nikolaus018/dji-fcc-esp32/hardware/fab/bom_full.csv

Qty | Value | Designators | Footprint | MPN | LCSC | Missing LCSC?
1 | 1uF | C1 | C_0603_1608Metric |  | C15849
6 | 10uF | C2 C4 C5 C6 C7 C13 | C_0805_2012Metric |  | C15850
5 | 100nF | C3 C8 C12 C14 C15 | C_0603_1608Metric |  | C14663
3 | 22uF | C9 C10 C11 | C_0805_2012Metric |  | C45783
2 | SMF5.0A | D1 D5 | D_SOD-123F | SMF5.0A | C707993
1 | SS34 | D4 | D_SMA | SS34 | C8678
1 | RED | D6 | LED_0603_1608Metric |  | C2286
1 | GREEN | D7 | LED_0603_1608Metric |  | C2986059
1 | BLUE | D8 | LED_0603_1608Metric |  | C2986058
2 | USB-C | J1 J2 | USB_C_Receptacle_HRO_TYPE-C-31-M-12 | TYPE-C-31-M-12 | C165948
1 | BATTERY 1S LiPo (+ on pin 1) | J3 | JST_PH_S2B-PH-SM4-TB_1x02-1MP_P2.00mm_Horizontal | S2B-PH-SM4-TB | C295747
1 | 4.7uH | L1 | L_Sunlord_SWPA4020S | SWPA4020S4R7MT | C48427
1 | FS8205A | Q1 | TSSOP-8_4.4x3mm_P0.65mm | FS8205A | C5148694
1 | 10k | R1 | R_0603_1608Metric |  | C25804
2 | 5.1k | R2 R3 | R_0603_1608Metric |  | C23186
1 | 4.7k | R4 | R_0603_1608Metric |  | C23162
1 | 100 | R7 | R_0603_1608Metric |  | C22775
1 | 1k | R8 | R_0603_1608Metric |  | C21190
1 | 220k | R9 | R_0603_1608Metric |  | C22961
1 | 30k | R10 | R_0603_1608Metric |  | C22984
4 | 100k | R11 R13 R14 R22 | R_0603_1608Metric |  | C25803
1 | 47k | R12 | R_0603_1608Metric |  | C25819
2 | 33k | R15 R16 | R_0603_1608Metric |  | C4216
2 | 470 | R17 R18 | R_0603_1608Metric |  | C23179
1 | 220 | R19 | R_0603_1608Metric |  | C22962
2 | 1M | R20 R21 | R_0603_1608Metric |  | C22935
1 | 150k | R23 | R_0603_1608Metric |  | C22807
1 | ESP32-S3-MINI-1-N8 | U1 | ESP32-S2-MINI-1 | ESP32-S3-MINI-1-N8 | C2913206
1 | AP2112K-3.3 | U2 | SOT-23-5 | AP2112K-3.3TRG1 | C51118
1 | TP4056 | U3 | SOIC-8-1EP_3.9x4.9mm_P1.27mm_EP2.41x3.3mm | TP4056-42-ESOP8 | C16581
1 | DW01A | U4 | SOT-23-6 | DW01A | C2927799
1 | MT3608 | U5 | SOT-23-6 | MT3608 | C84817
1 | TPS2553DBVR | U6 | SOT-23-6 | TPS2553DBVR | C55266
2 | USBLC6-2SC6 | U7 U9 | SOT-23-6 | USBLC6-2SC6 | C7519
1 | FSUSB42MUX | U8 | MSOP-10_3x3mm_P0.5mm | FSUSB42MUX | C11355
