nikolaus018/dji-fcc-esp32/hardware/fab/dji-fcc.step

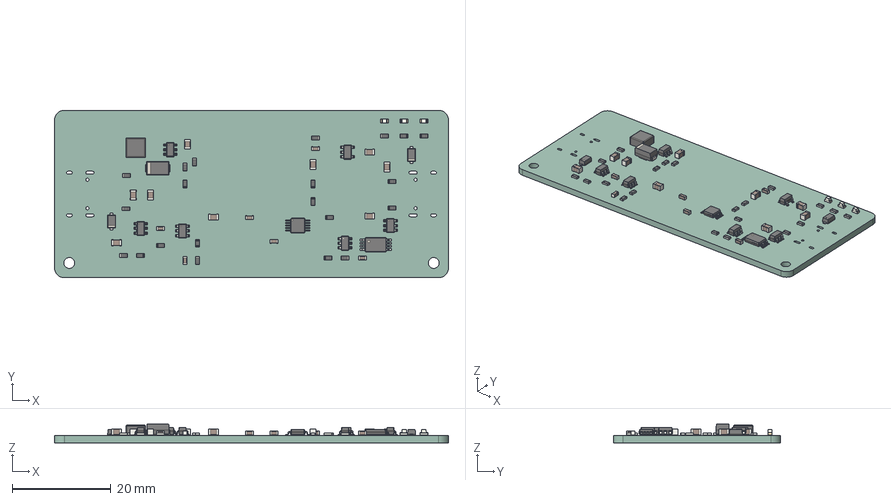
[picture p3: CAD file, 2026-10-11]
hardware/fab/dji-fcc.step
80.0 x 34.0 x 3.82 mm
C_0603_1608Metric x 6
R_0603_1608Metric x 21
SOT-23-6 x 5
LED_0603_1608Metric x 3
SOT-23-5
C_0805_2012Metric x 9
a671c444-8551-11ed-a139-00155d22e2d7_part
a671c57a-8551-11ed-a139-00155d22e2d7_part
a671c5fc-8551-11ed-a139-00155d22e2d7_part
TSSOP-8_4.4x3mm_P0.65mm
D_SMA
D_SOD_123F x 2
MSOP-10_3x3mm_P0.5mm
dji-fcc_PCB
