nikolaus018/dji-fcc-esp32/hardware/docs/schematic.pdf

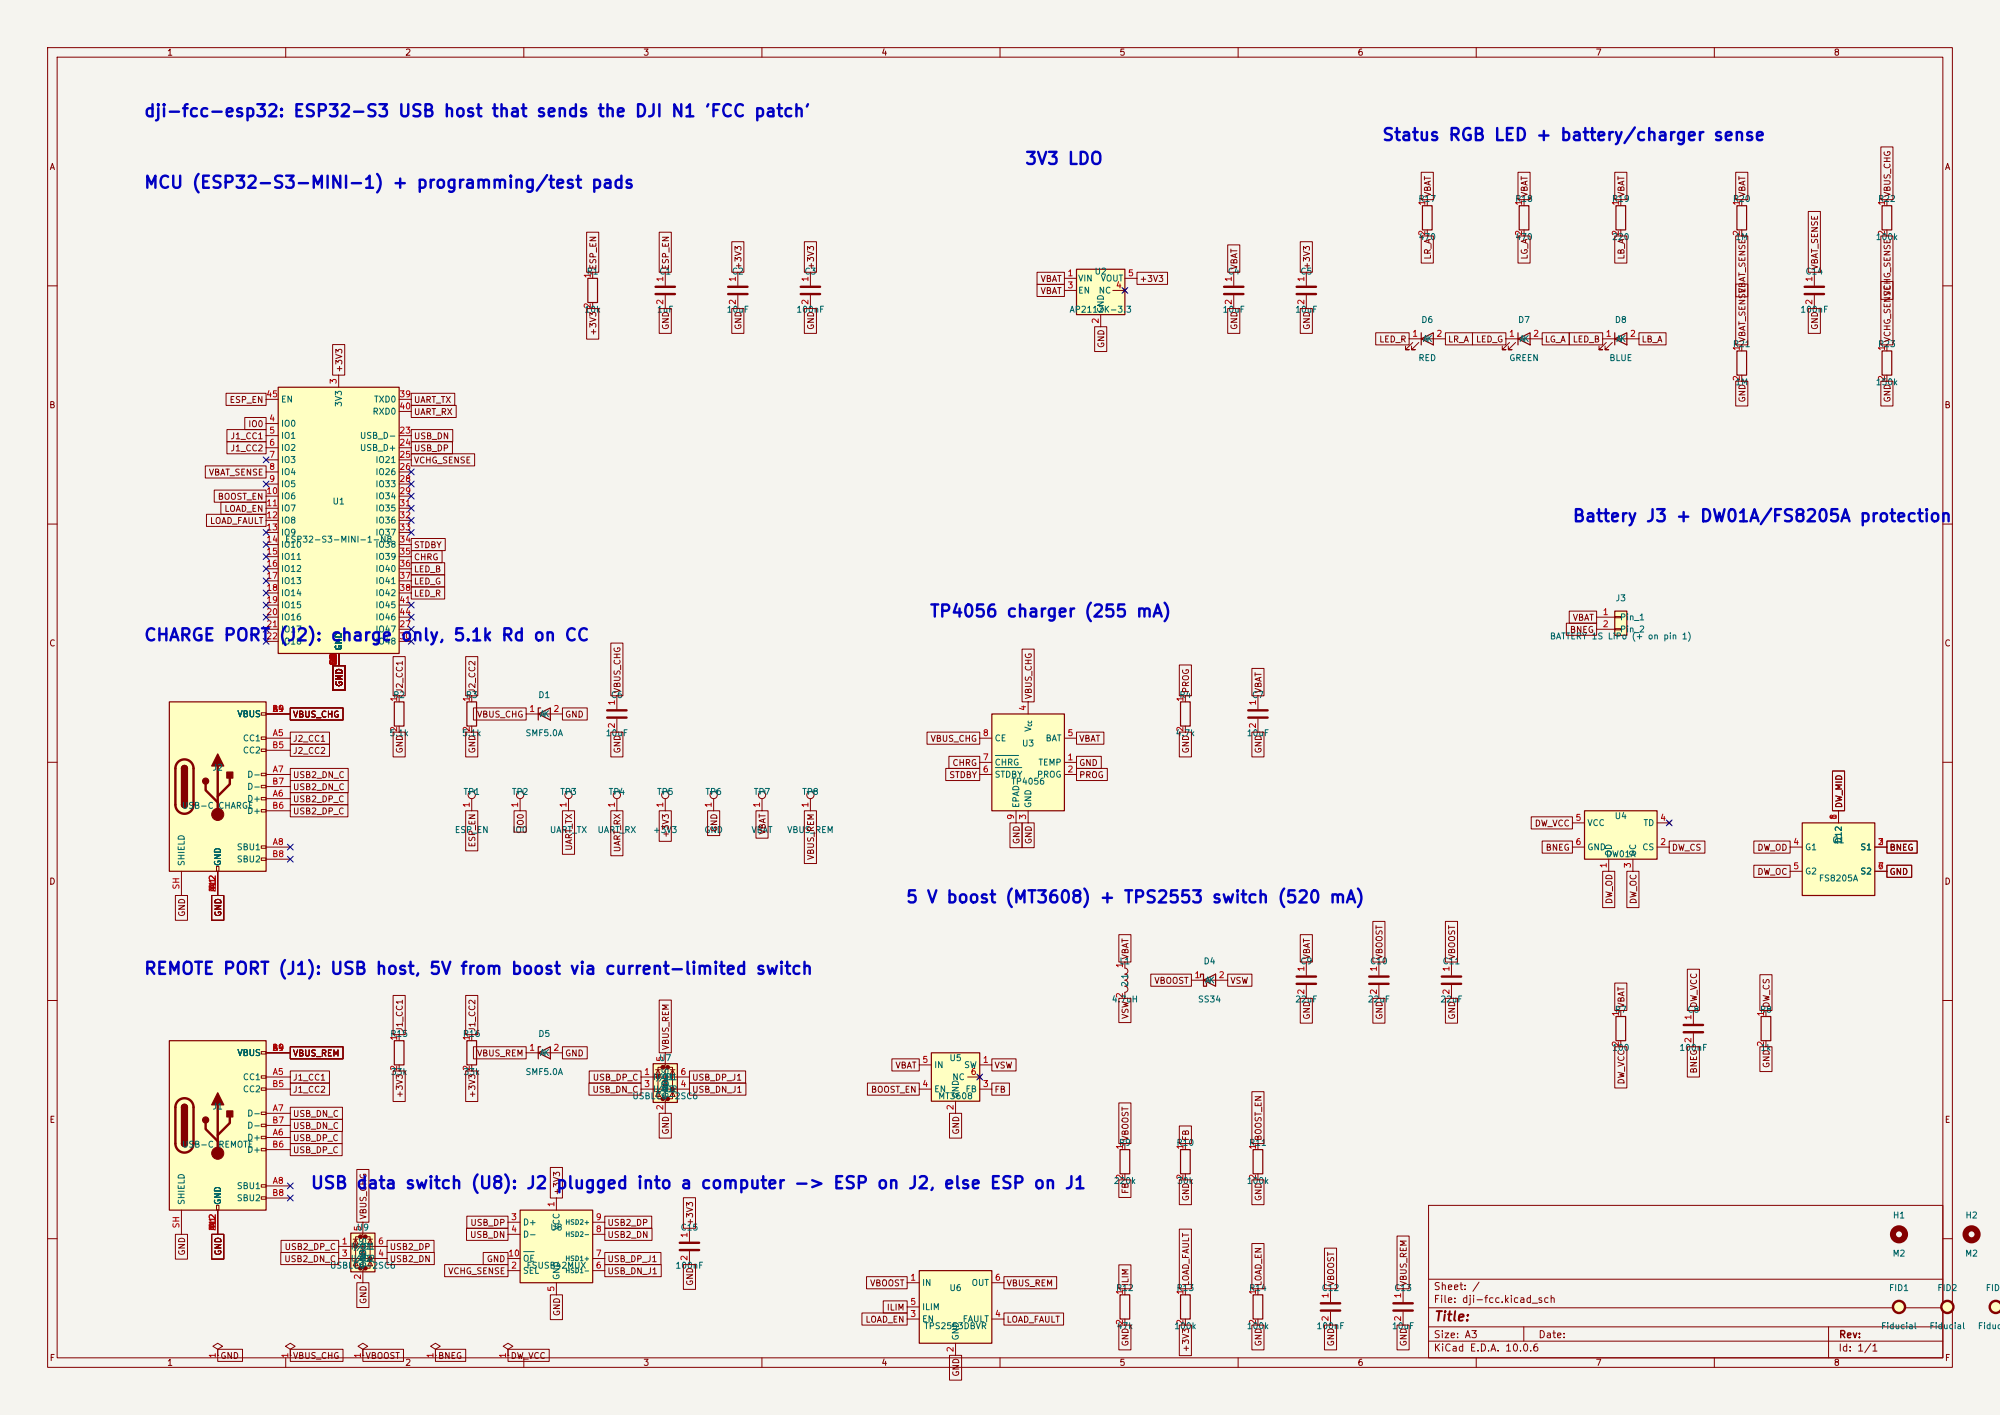
[picture p4: page 1]

dji-fcc-esp32: ESP32-S3 USB host that sends the DJI N1 'FCC patch'

Status RGB LED + battery/charger sense

MCU (ESP32-S3-MINI-1) + programming/test pads

J3 BATTERY 1S LiPo (+ on pin 1) OD

REMOTE PORT (J1): USB host, 5V from boost via current-limited switch

Size: A3 | Rev: | F Date:
KiCad E.D.A. 10.0.6 | Id: 1/1
