nikolaus018/dji-fcc-esp32/hardware/docs/pcb_bottom.pdf

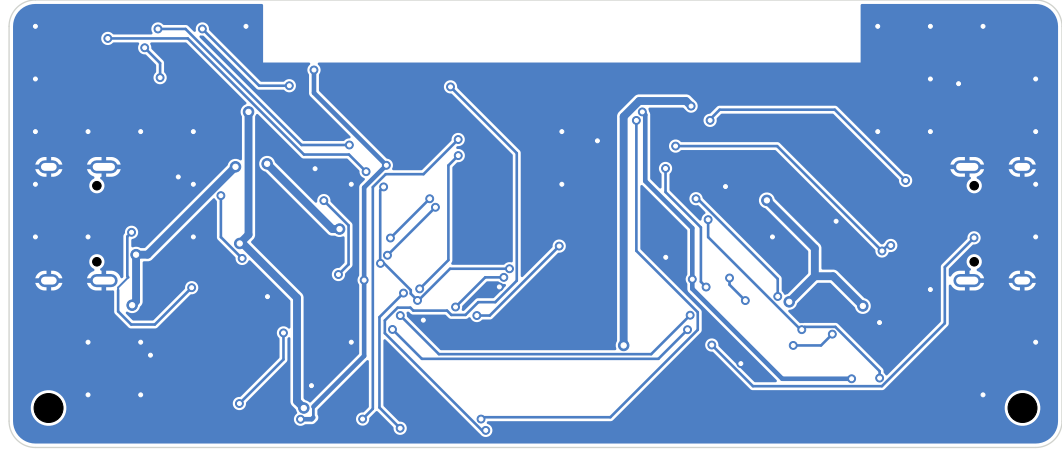
[picture p5: page 1]
