nikolaus018/dji-fcc-esp32/hardware/docs/pcb_top.pdf

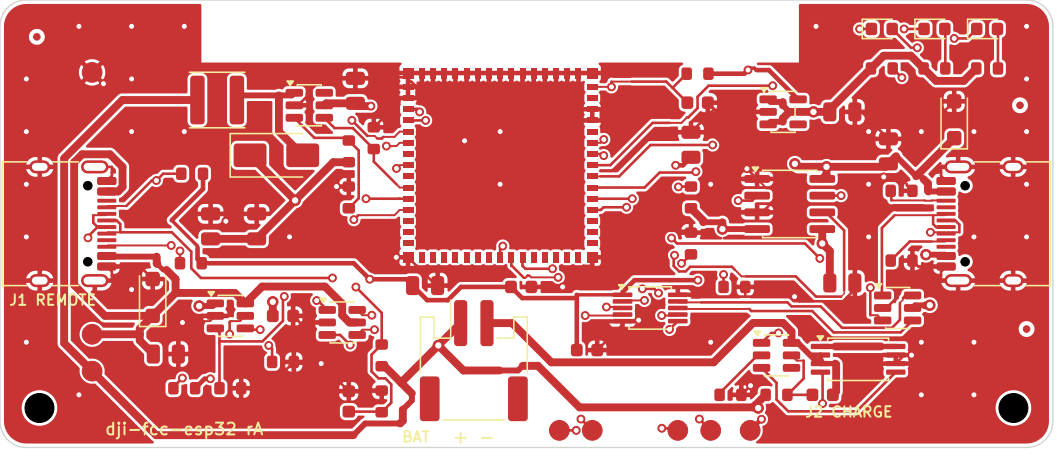
[picture p6: page 1]
