nikolaus018/dji-fcc-esp32/hardware/dji-fcc.kicad_pcb

## KiCad design hardware/dji-fcc.kicad_pcb (2026-10-11)

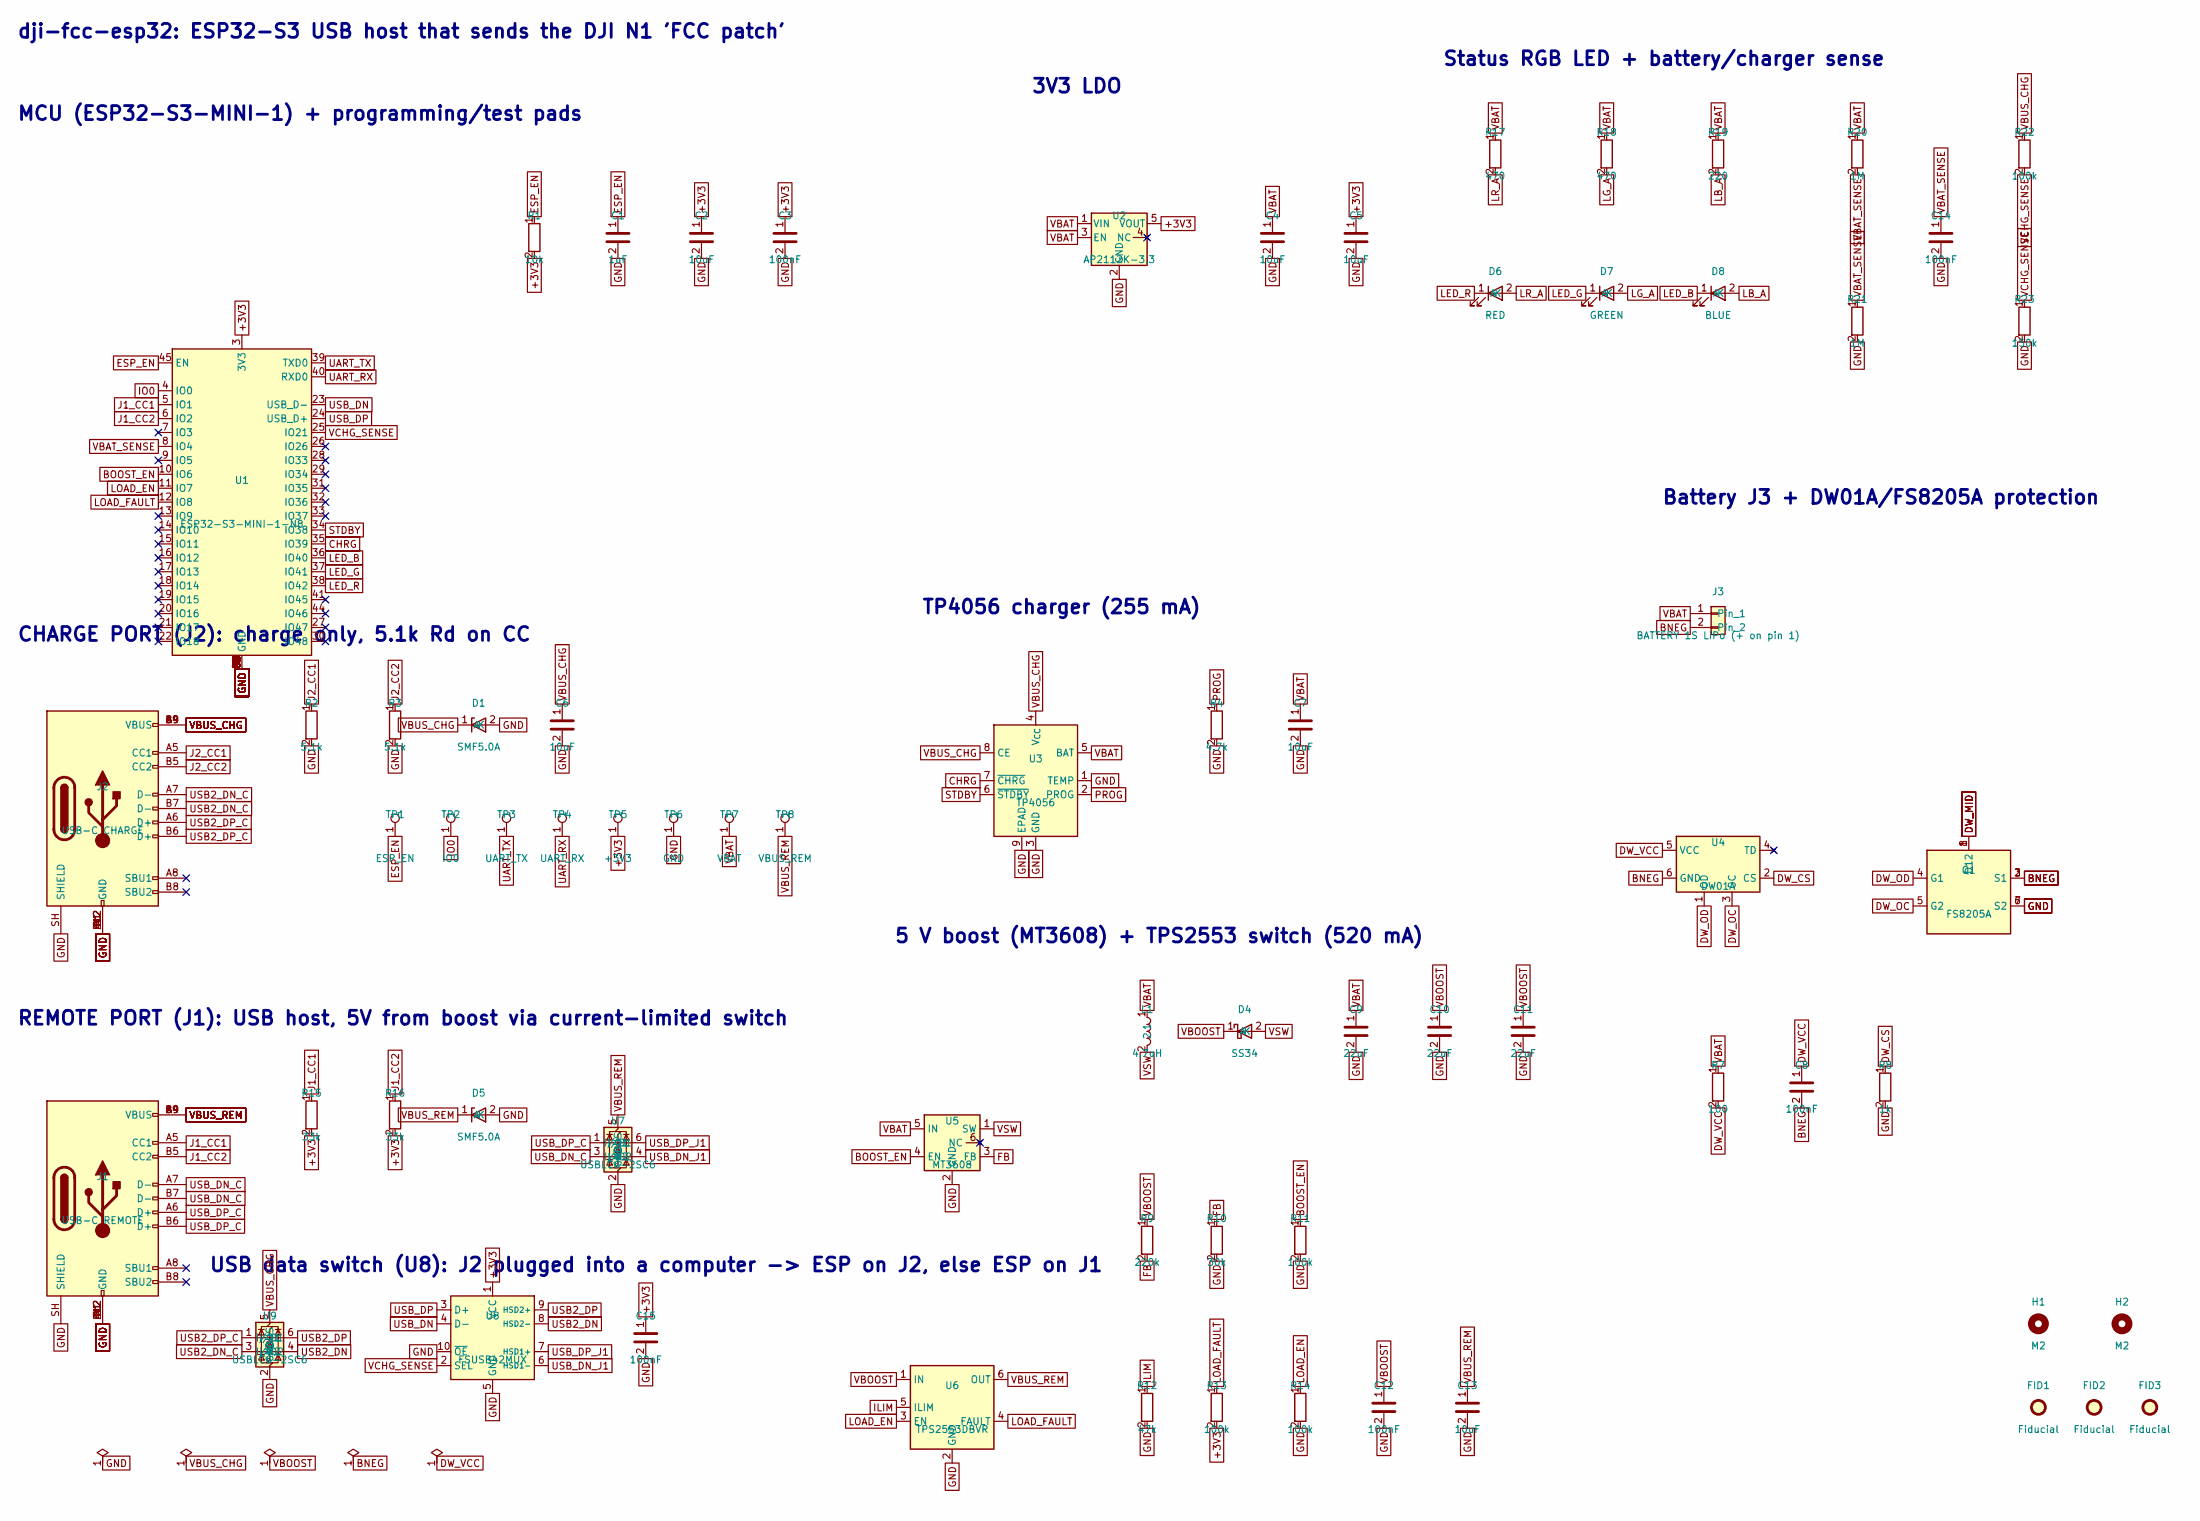
[picture p7: schematic dji-fcc.kicad_sch]

Parts:
C1: 1uF; C_0603_1608Metric
C2, C4, C5, C6, C7, C13: 10uF; C_0805_2012Metric
C3, C8, C12, C14, C15: 100nF; C_0603_1608Metric
C9, C10, C11: 22uF; C_0805_2012Metric
D1, D5: SMF5.0A; D_SOD-123F; MPN SMF5.0A
D4: SS34; D_SMA; MPN SS34
D6: RED; LED_0603_1608Metric
D7: GREEN; LED_0603_1608Metric
D8: BLUE; LED_0603_1608Metric
FID1, FID2, FID3: Fiducial; Fiducial_0.5mm_Mask1mm
H1, H2: M2; MountingHole_2.2mm_M2
J1: USB-C REMOTE; USB_C_Receptacle_HRO_TYPE-C-31-M-12; MPN TYPE-C-31-M-12
J2: USB-C CHARGE; USB_C_Receptacle_HRO_TYPE-C-31-M-12; MPN TYPE-C-31-M-12
J3: BATTERY 1S LiPo (+ on pin 1); JST_PH_S2B-PH-SM4-TB_1x02-1MP_P2.00mm_Horizontal; MPN S2B-PH-SM4-TB
L1: 4.7uH; L_Sunlord_SWPA4020S; MPN SWPA4020S4R7MT
Q1: FS8205A; TSSOP-8_4.4x3mm_P0.65mm; MPN FS8205A
R1: 10k; R_0603_1608Metric
R2, R3: 5.1k; R_0603_1608Metric
R4: 4.7k; R_0603_1608Metric
R7: 100; R_0603_1608Metric
R8: 1k; R_0603_1608Metric
R9: 220k; R_0603_1608Metric
R10: 30k; R_0603_1608Metric
R11, R13, R14, R22: 100k; R_0603_1608Metric
R12: 47k; R_0603_1608Metric
R15, R16: 33k; R_0603_1608Metric
R17, R18: 470; R_0603_1608Metric
R19: 220; R_0603_1608Metric
R20, R21: 1M; R_0603_1608Metric
R23: 150k; R_0603_1608Metric
TP1: ESP_EN; TestPoint_Pad_D1.5mm
TP2: IO0; TestPoint_Pad_D1.5mm
TP3: UART_TX; TestPoint_Pad_D1.5mm
TP4: UART_RX; TestPoint_Pad_D1.5mm
TP5: +3V3; TestPoint_Pad_D1.5mm
TP6: GND; TestPoint_Pad_D1.5mm
TP7: VBAT; TestPoint_Pad_D1.5mm
TP8: VBUS_REM; TestPoint_Pad_D1.5mm
U1: ESP32-S3-MINI-1-N8; ESP32-S2-MINI-1; MPN ESP32-S3-MINI-1-N8
U2: AP2112K-3.3; SOT-23-5; MPN AP2112K-3.3TRG1
U3: TP4056; SOIC-8-1EP_3.9x4.9mm_P1.27mm_EP2.41x3.3mm; MPN TP4056-42-ESOP8
U4: DW01A; SOT-23-6; MPN DW01A
U5: MT3608; SOT-23-6; MPN MT3608
U6: TPS2553DBVR; SOT-23-6; MPN TPS2553DBVR
U7, U9: USBLC6-2SC6; SOT-23-6; MPN USBLC6-2SC6
U8: FSUSB42MUX; MSOP-10_3x3mm_P0.5mm; MPN FSUSB42MUX

Connections:
+3V3: C2.1, C3.1, C5.1, C15.1, R1.2, R13.2, R15.2, R16.2, TP5.1, U1.3 (3V3), U2.5 (VOUT), U8.1 (VCC)
BNEG: C8.2, J3.2, Q1.2 (S1), Q1.3 (S1), U4.6 (GND)
BOOST_EN: R11.1, U1.10 (IO6), U5.4 (EN)
CHRG: U1.35 (IO39), U3.7 (~CHRG)
DW_CS: R8.1, U4.2 (CS)
DW_MID: Q1.1 (D12), Q1.8 (D12)
DW_OC: Q1.5 (G2), U4.3 (OC)
DW_OD: Q1.4 (G1), U4.1 (OD)
DW_VCC: C8.1, R7.2, U4.5 (VCC)
ESP_EN: C1.1, R1.1, TP1.1, U1.45 (EN)
FB: R9.2, R10.1, U5.3 (FB)
GND: C1.2, C2.2, C3.2, C4.2, C5.2, C6.2, C7.2, C9.2, C10.2, C11.2, C12.2, C13.2, C14.2, C15.2, D1.2 (A), D5.2 (A), J1.A1 (GND), J1.A12 (GND), J1.B1 (GND), J1.B12 (GND), J1.SH (SHIELD), J2.A1 (GND), J2.A12 (GND), J2.B1 (GND), J2.B12 (GND), J2.SH (SHIELD), Q1.6 (S2), Q1.7 (S2), R2.2, R3.2, R4.2, R8.2, R10.2, R11.2, R12.2, R14.2, R21.2, R23.2, TP6.1, U1.1 (GND), U1.2 (GND), U1.42 (GND), U1.43 (GND), U1.46 (GND), U1.47 (GND), U1.48 (GND), U1.49 (GND), U1.50 (GND), U1.51 (GND), U1.52 (GND), U1.53 (GND), U1.54 (GND), U1.55 (GND), U1.56 (GND), U1.57 (GND), U1.58 (GND), U1.59 (GND), U1.60 (GND), U1.61 (GND), U1.62 (GND), U1.63 (GND), U1.64 (GND), U1.65 (GND), U2.2 (GND), U3.1 (TEMP), U3.3 (GND), U3.9 (EPAD), U5.2 (GND), U6.2 (GND), U7.2 (GND), U8.5 (GND), U8.10 (~OE), U9.2 (GND)
ILIM: R12.1, U6.5 (ILIM)
IO0: TP2.1, U1.4 (IO0)
J1_CC1: J1.A5 (CC1), R15.1, U1.5 (IO1)
J1_CC2: J1.B5 (CC2), R16.1, U1.6 (IO2)
J2_CC1: J2.A5 (CC1), R2.1
J2_CC2: J2.B5 (CC2), R3.1
LB_A: D8.2 (A), R19.2
LED_B: D8.1 (K), U1.36 (IO40)
LED_G: D7.1 (K), U1.37 (IO41)
LED_R: D6.1 (K), U1.38 (IO42)
LG_A: D7.2 (A), R18.2
LOAD_EN: R14.1, U1.11 (IO7), U6.3 (EN)
LOAD_FAULT: R13.1, U1.12 (IO8), U6.4 (FAULT)
LR_A: D6.2 (A), R17.2
PROG: R4.1, U3.2 (PROG)
STDBY: U1.34 (IO38), U3.6 (~STDBY)
UART_RX: TP4.1, U1.40 (RXD0)
UART_TX: TP3.1, U1.39 (TXD0)
USB2_DN: U8.8 (HSD2-), U9.4 (I/O2)
USB2_DN_C: J2.A7 (D-), J2.B7 (D-), U9.3 (I/O2)
USB2_DP: U8.9 (HSD2+), U9.6 (I/O1)
USB2_DP_C: J2.A6 (D+), J2.B6 (D+), U9.1 (I/O1)
USB_DN: U1.23 (USB_D-), U8.4 (D-)
USB_DN_C: J1.A7 (D-), J1.B7 (D-), U7.3 (I/O2)
USB_DN_J1: U7.4 (I/O2), U8.6 (HSD1-)
USB_DP: U1.24 (USB_D+), U8.3 (D+)
USB_DP_C: J1.A6 (D+), J1.B6 (D+), U7.1 (I/O1)
USB_DP_J1: U7.6 (I/O1), U8.7 (HSD1+)
VBAT: C4.1, C7.1, C9.1, J3.1, L1.1, R7.1, R17.1, R18.1, R19.1, R20.1, TP7.1, U2.1 (VIN), U2.3 (EN), U3.5 (BAT), U5.5 (IN)
VBAT_SENSE: C14.1, R20.2, R21.1, U1.8 (IO4)
VBOOST: C10.1, C11.1, C12.1, D4.1 (K), R9.1, U6.1 (IN)
VBUS_CHG: C6.1, D1.1 (K), J2.A4 (VBUS), J2.A9 (VBUS), J2.B4 (VBUS), J2.B9 (VBUS), R22.1, U3.4 (V_{CC}), U3.8 (CE), U9.5 (VBUS)
VBUS_REM: C13.1, D5.1 (K), J1.A4 (VBUS), J1.A9 (VBUS), J1.B4 (VBUS), J1.B9 (VBUS), TP8.1, U6.6 (OUT), U7.5 (VBUS)
VCHG_SENSE: R22.2, R23.1, U1.25 (IO21), U8.2 (SEL)
VSW: D4.2 (A), L1.2, U5.1 (SW)

Notes on the sheet:
dji-fcc-esp32: ESP32-S3 USB host that sends the DJI N1 'FCC patch'
MCU (ESP32-S3-MINI-1) + programming/test pads
3V3 LDO
Status RGB LED + battery/charger sense
REMOTE PORT (J1): USB host, 5V from boost via current-limited switch
5 V boost (MT3608) + TPS2553 switch (520 mA)
USB data switch (U8): J2 plugged into a computer -> ESP on J2, else ESP on J1
CHARGE PORT (J2): charge only, 5.1k Rd on CC
TP4056 charger (255 mA)
Battery J3 + DW01A/FS8205A protection

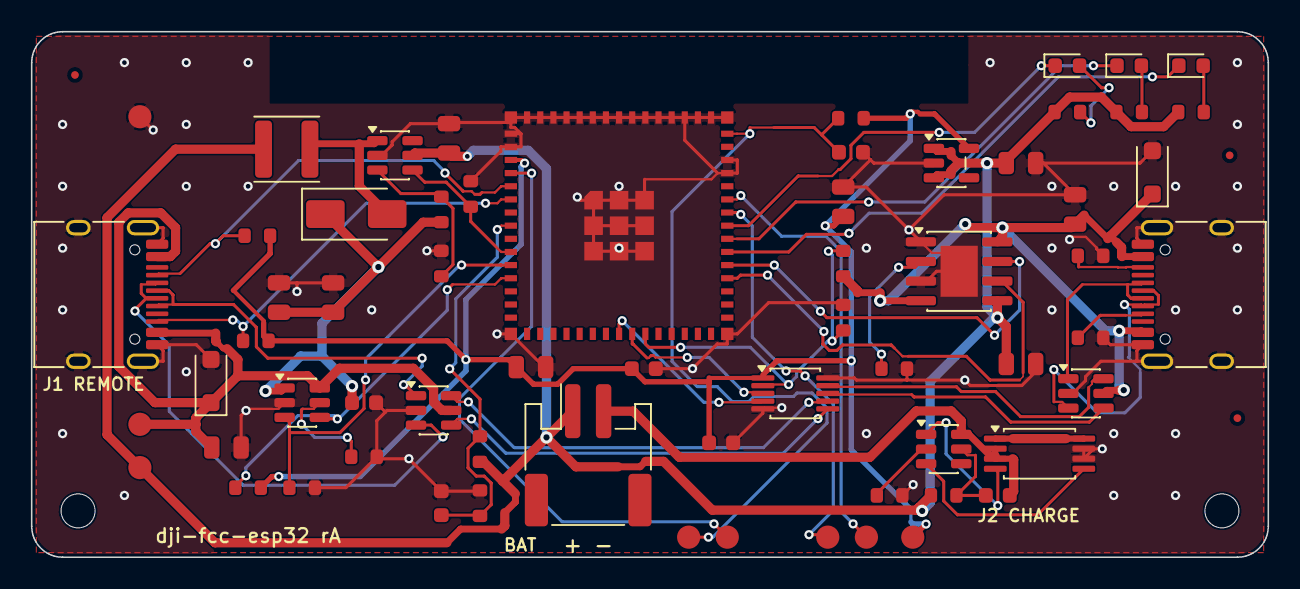
[picture p8: board dji-fcc.kicad_pcb from above]

Board: 2 copper layers, 80.0 x 34.0 mm, 69 parts (0 on the bottom side), 47 nets.
