nikolaus018/dji-fcc-esp32/(commit log)

2026-10-11 ESP32-S3 firmware to switch DJI N1 remotes to FCC mode
2026-10-11 Add custom PCB (KiCad, generated), board abstraction and battery-powered firmware variant
    [bom_full.csv, bom_jlcpcb.csv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]
2026-10-11 Flash and update over USB-C: FSUSB42 data switch between J1/J2, charge status on ESP, wider board
    [bom_full.csv, bom_jlcpcb.csv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]
2026-10-11 Final review: fix battery drain paths in custom-PCB firmware, portable hardware scripts
    Firmware (custom PCB):
    - Patch once per plug-in and deep sleep while the remote stays attached (EXT1 re-armed
    for unplug) instead of polling awake until it is removed
    - Low battery no longer wake-loops while the remote is plugged in; a brown-out reset is
    treated as low battery
    - Charge mode: stay awake only while a USB host is connected, otherwise sleep with the
    LED held so the TP4056 can reach its end-of-charge current
    - Ignore the Ra of e-marked cables when detecting the remote on CC
    Hardware tooling: tool and scratch paths come from tools/env.sh and can be overridden.
    Docs updated to match; .DS_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
    [board.h, board_custom.c, board_devkit.c, dji.c, gen_sch.py]
2026-10-11 BOM: merge J1/J2 into one line, substitute out-of-stock parts
    - J1 and J2 share one LCSC part; JLCPCB rejects the same part on two BOM lines
    - Q1: HXY MOSFET 8205A (C5148694) instead of Fortune FS8205A (out of stock)
    - D7/D8: same Everlight 19-217 LEDs on the /6T reel (C2986059, C2986058)
    [bom_full.csv, bom_jlcpcb.csv]
2026-10-11 Add browser web flasher (ESP Web Tools) with prebuilt dev-board and custom-PCB firmware
