nikolaus018/dji-fcc-esp32/(notices)

Notices in the files:
README.md:
MIT license
